JuanfraTr/cmos-image-sensor/README.md

[Informe del diseño y layout de un chip sensor de imagen CMOS](Informe_CMOS_Image_Sensor.pdf)
