JuanfraTr/cmos-image-sensor/Images/esquematico.PNG

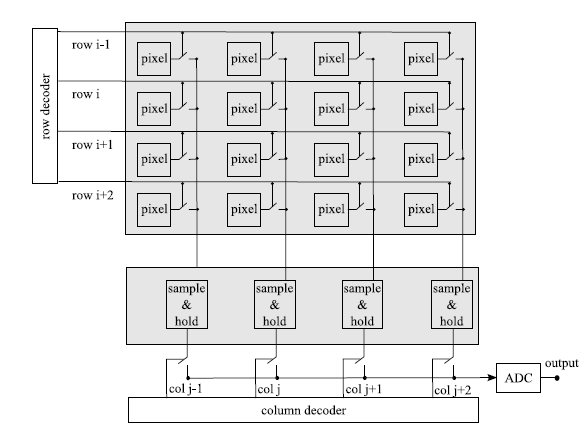
Images/esquematico.PNG
