JuanfraTr/cmos-image-sensor/Images/pinned.png

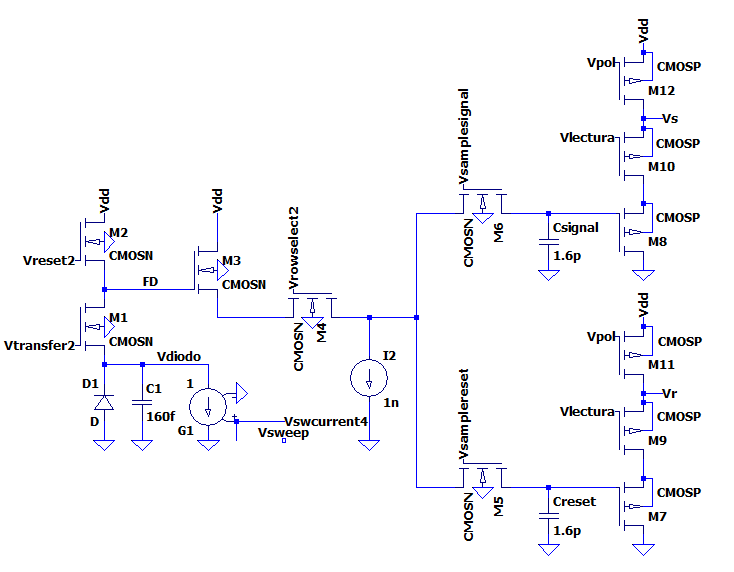
Images/pinned.png
