JuanfraTr/cmos-image-sensor/Images/tiempos.png

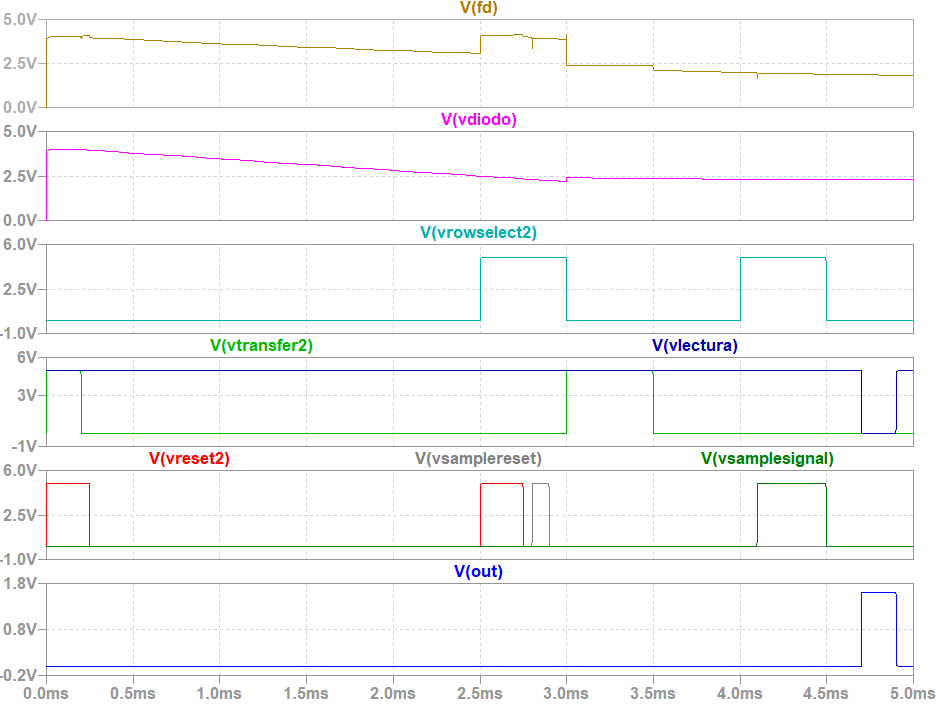
Images/tiempos.png
