JuanfraTr/cmos-image-sensor/Images/variandoCph.png

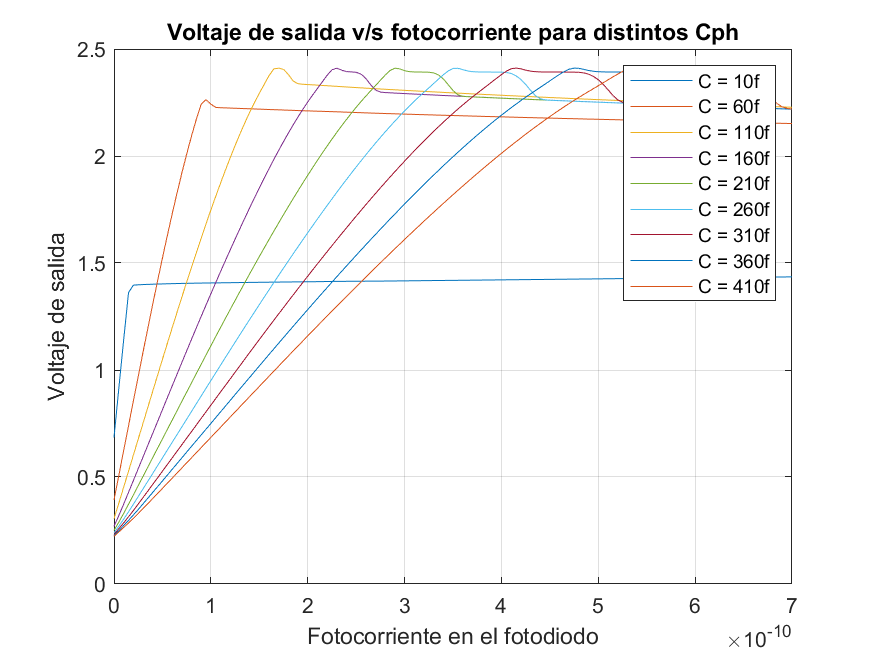
Images/variandoCph.png
