JuanfraTr/cmos-image-sensor/Images/variandoCsyCr.png

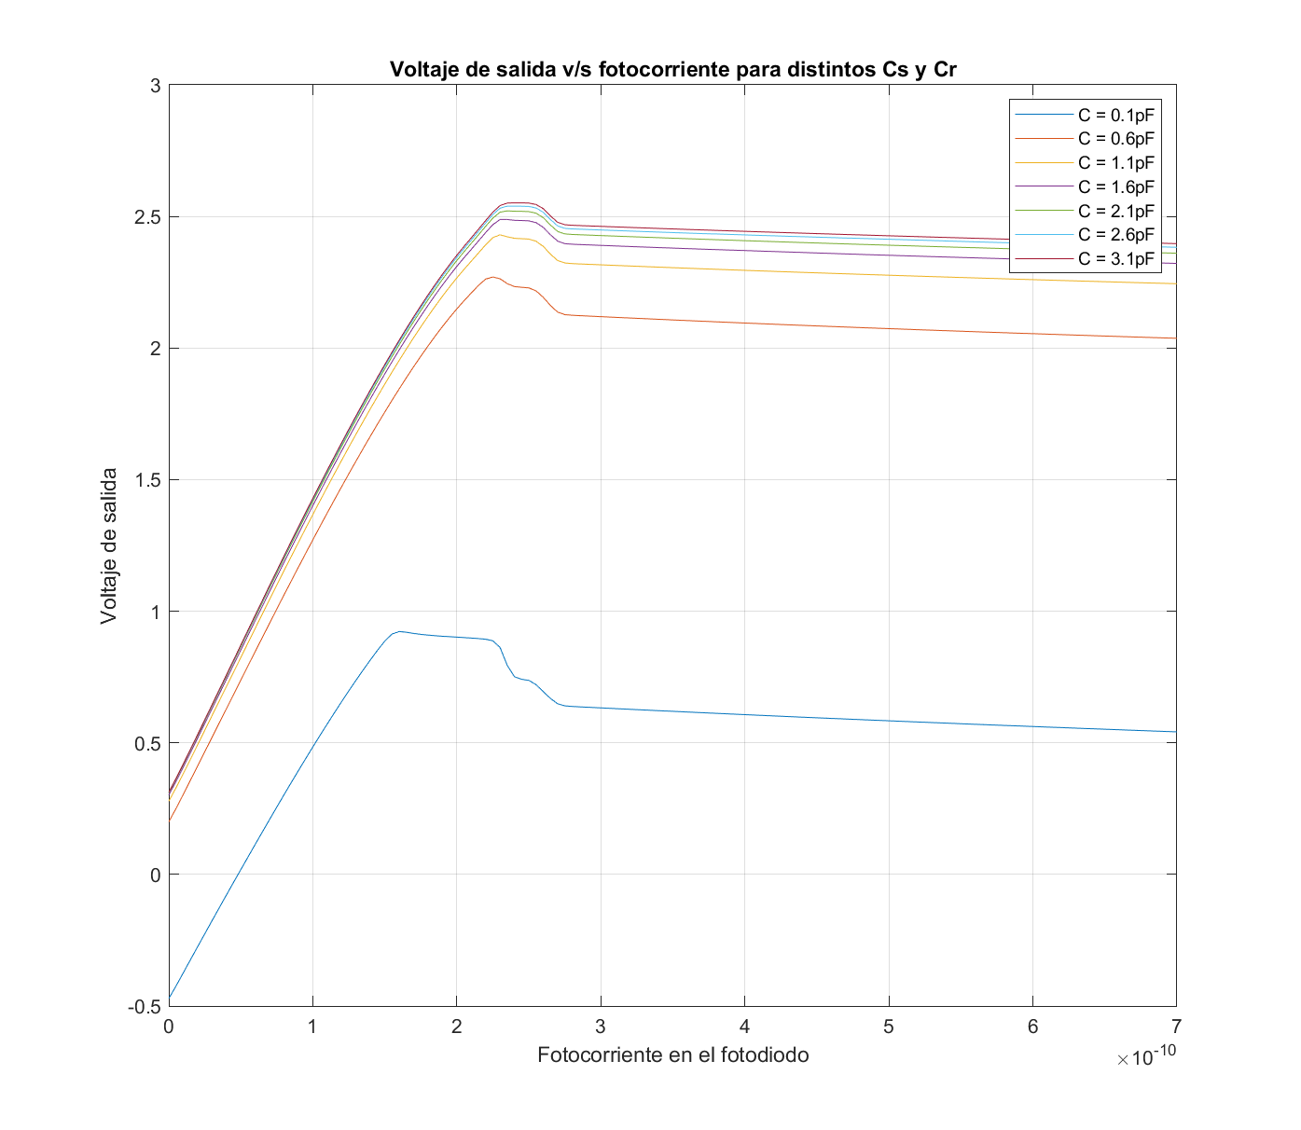
Images/variandoCsyCr.png
