JuanfraTr/cmos-image-sensor/Images/variandom.png

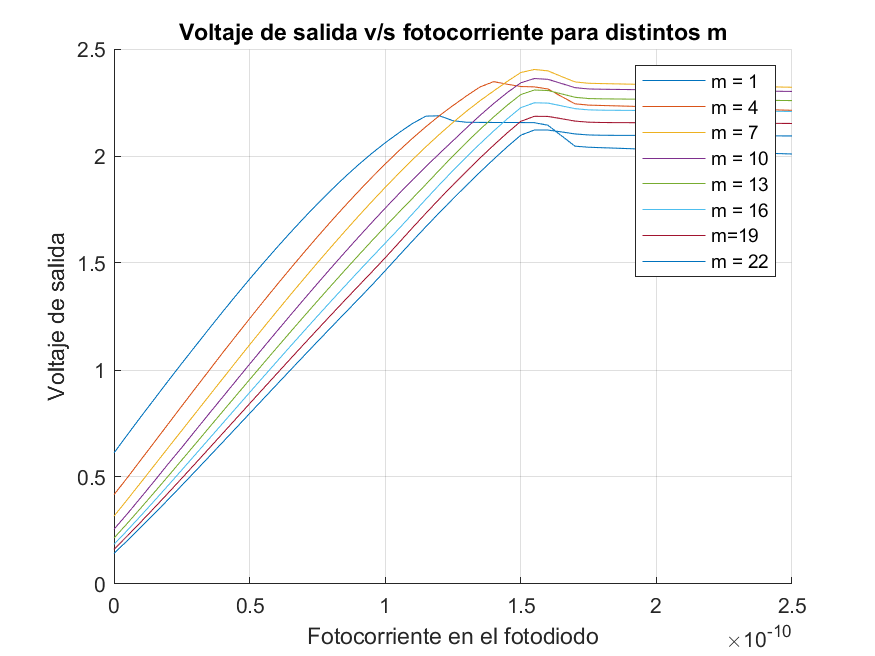
Images/variandom.png
