JuanfraTr/cmos-image-sensor/Images/variandoVpol.png

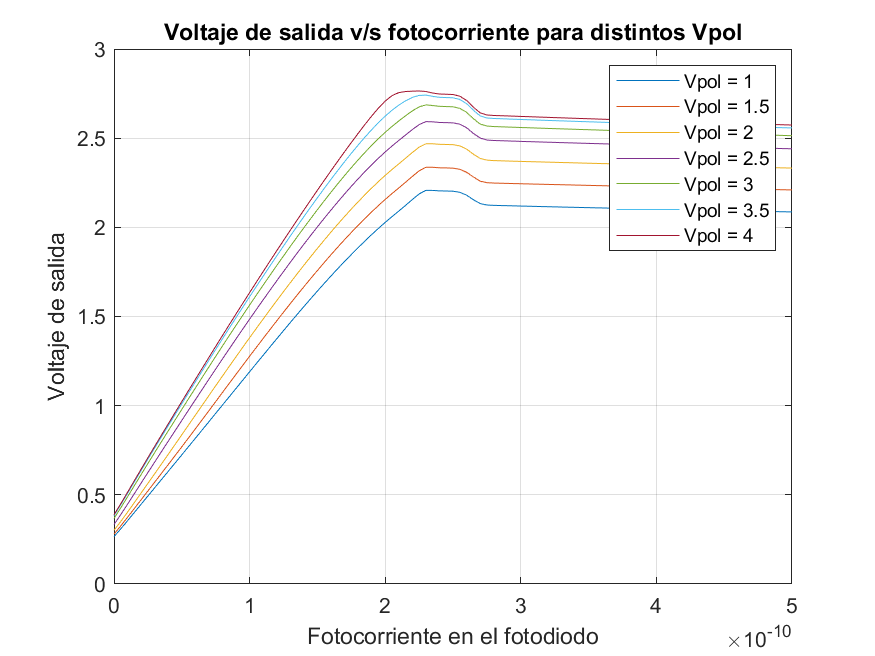
Images/variandoVpol.png
