JuanfraTr/cmos-image-sensor/Images/variandowp1.png

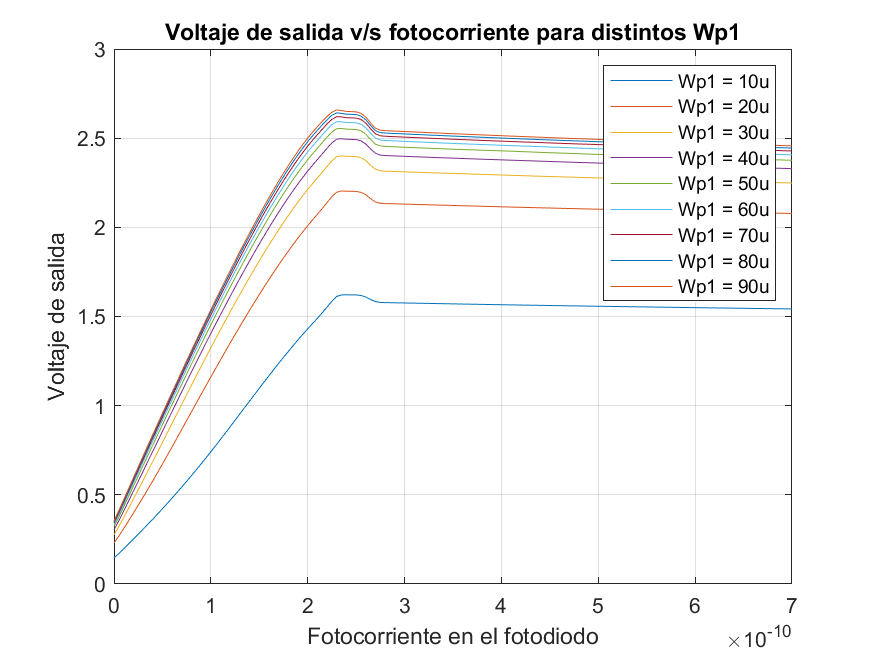
Images/variandowp1.png
