JuanfraTr/cmos-image-sensor/Images/variandoWp2.png

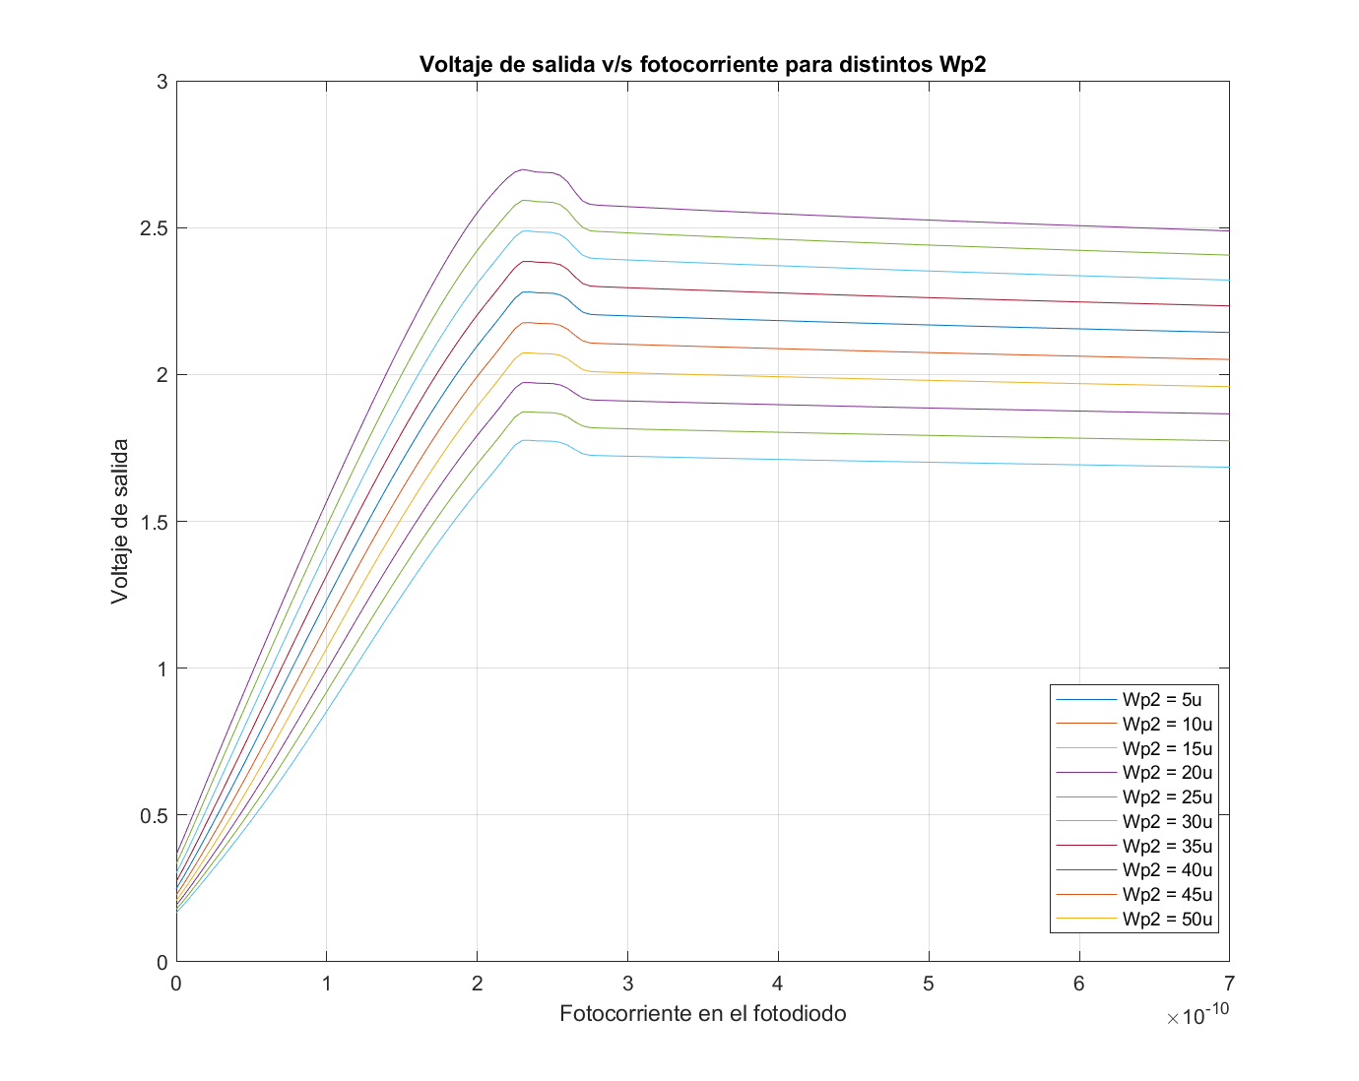
Images/variandoWp2.png
