JuanfraTr/cmos-image-sensor/Images/wchico.png

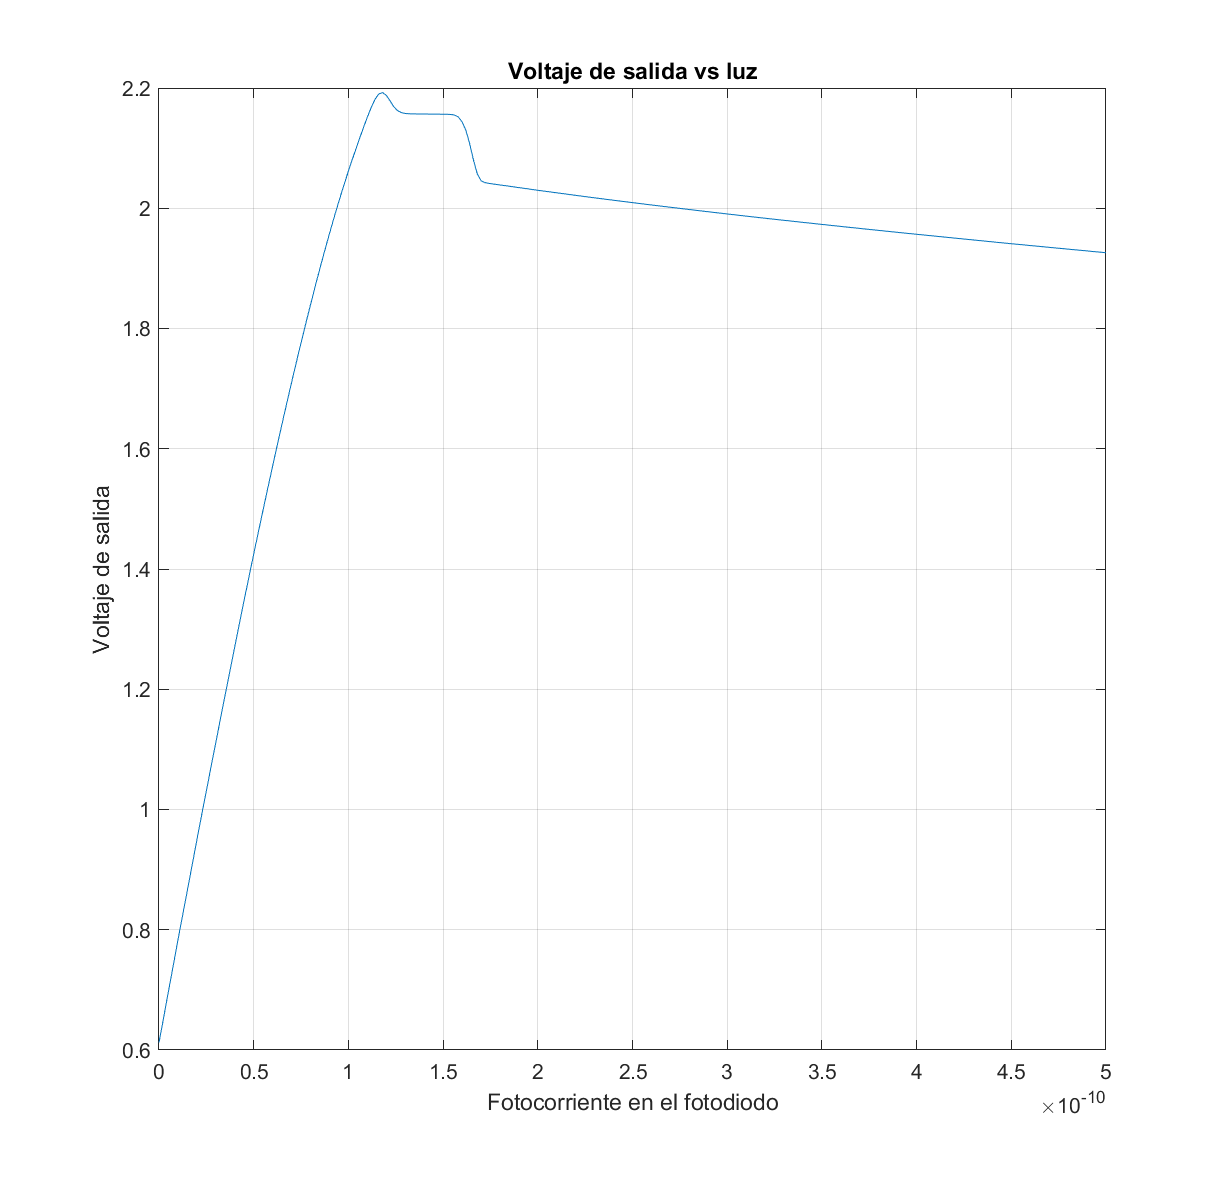
Images/wchico.png
