JuanfraTr/cmos-image-sensor/Images/wgrande.png

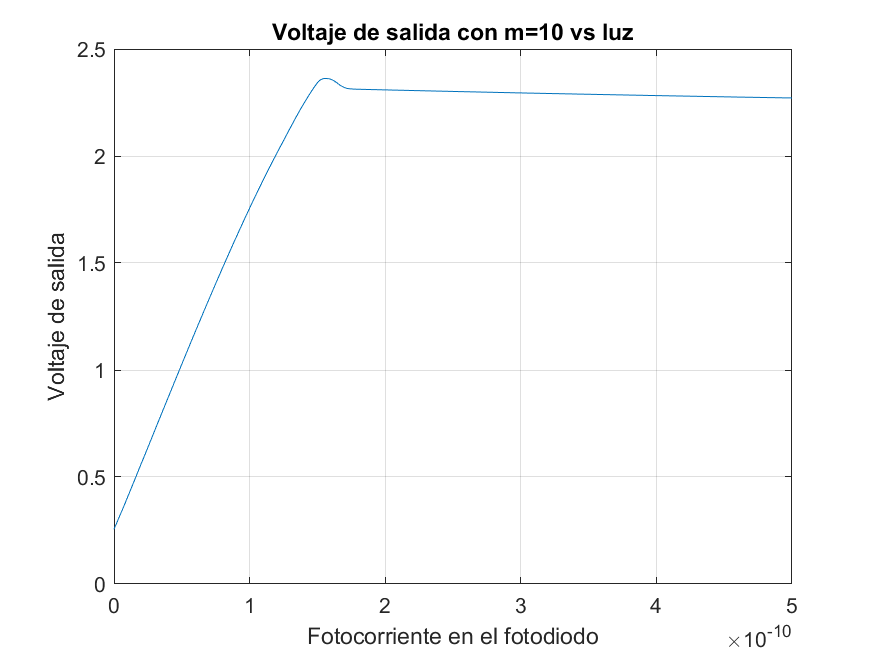
Images/wgrande.png
