JuanfraTr/cmos-image-sensor/Matlab Simulations/html/simulaciones_varias_01.png

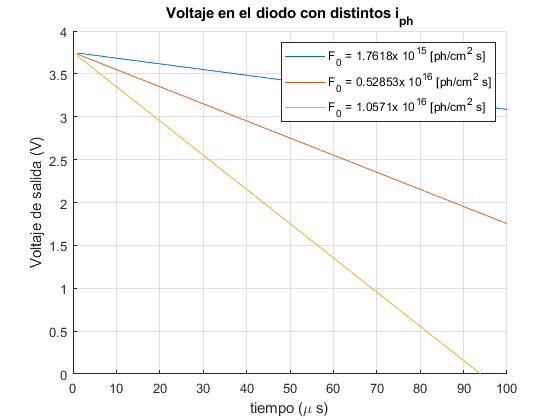
Matlab Simulations/html/simulaciones_varias_01.png
