JuanfraTr/cmos-image-sensor/SPICE Simulations/esquema_general.png

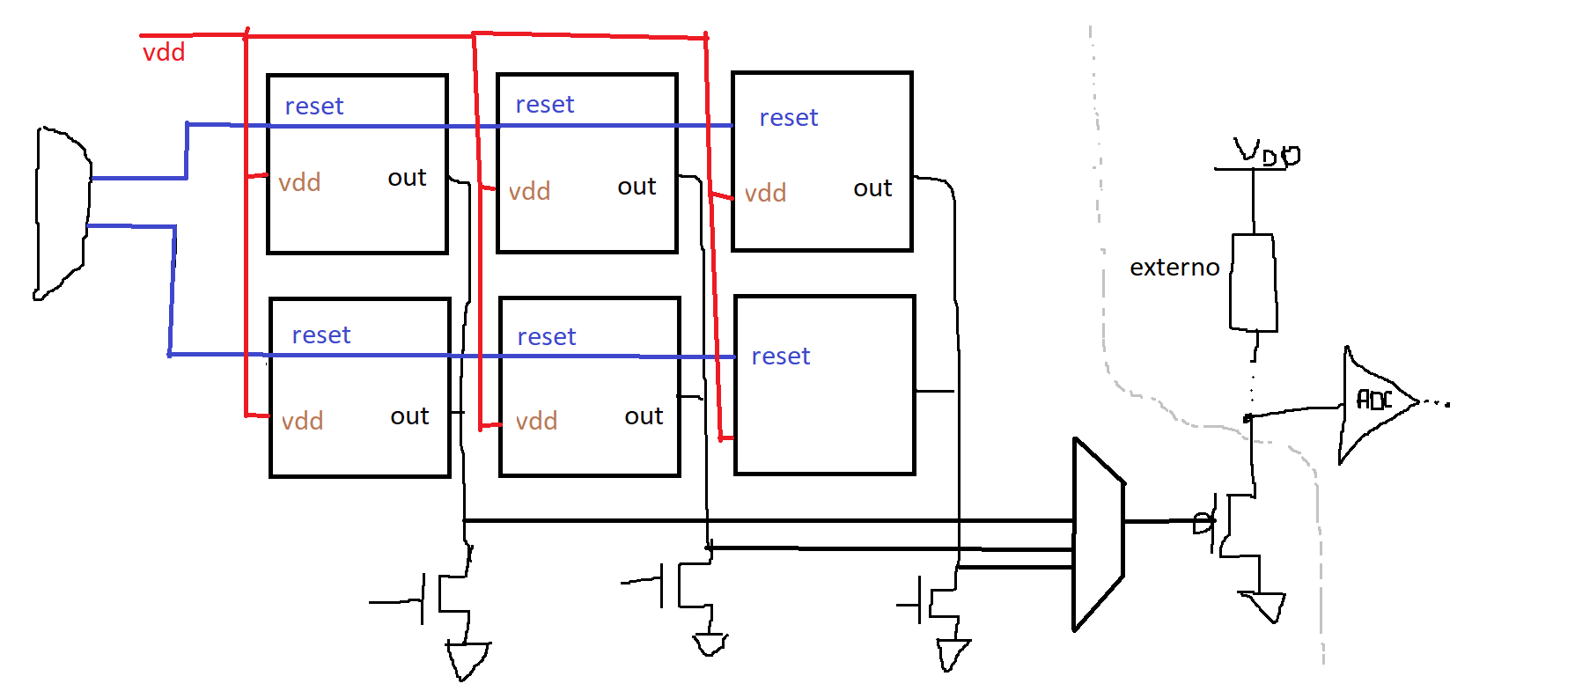
SPICE Simulations/esquema_general.png
