JuanfraTr/cmos-image-sensor/SPICE Simulations/Geometria_Aprox.png

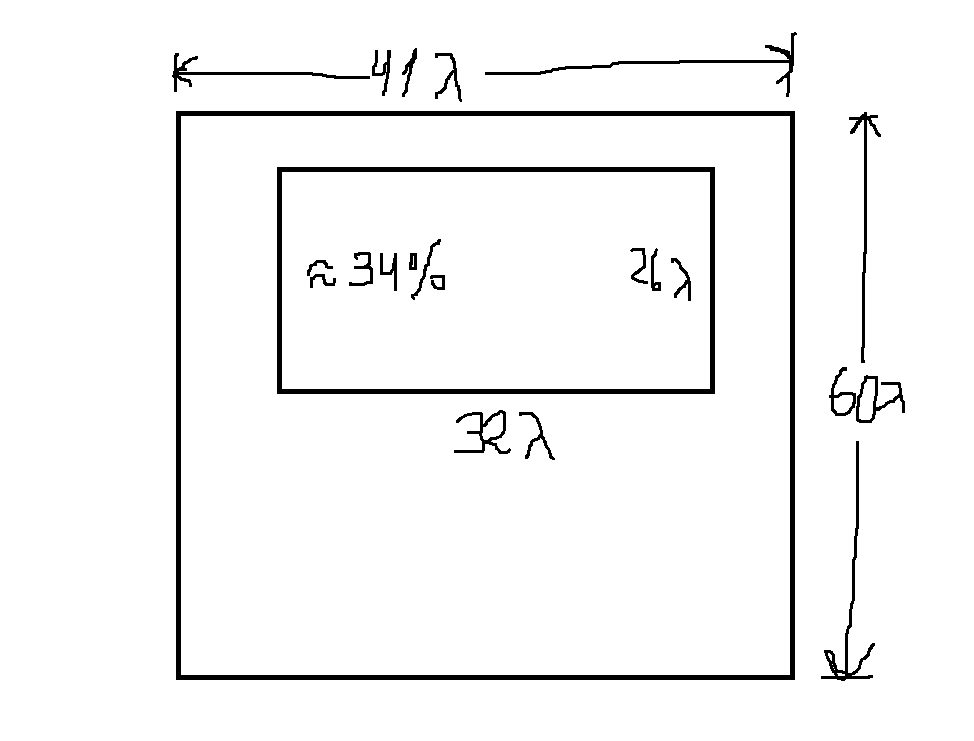
SPICE Simulations/Geometria_Aprox.png
