JuanfraTr/cmos-image-sensor/SPICE Simulations/3T-APS.asc

C1: cap; 2p
D1: diode; photodiode
G1: g; 1
M1: nmos4; l='Lmin' w='W' ad='W*Ld' as='W*Ld' pd='2*W+2*Ld' ps='2*W+2*Ld' m=1
M2: nmos4; l='Lmin' w='W' ad='W*Ld' as='W*Ld' pd='2*W+2*Ld' ps='2*W+2*Ld' m=1
M3: nmos4; l='Lmin' w='W' ad='W*Ld' as='W*Ld' pd='2*W+2*Ld' ps='2*W+2*Ld' m=1
M4: nmos4; l='Lbias' w='Wbias' ad='Wbias*Ld' as='Wbias*Ld' pd='2*Wbias+2*Ld' ps='2*Wbias+2*Ld' m=1
M5: pmos4; l='Lmin' w='Wbuf' ad='Ld*Wbuf' as='Ld*Wbuf' pd='2*Ld+2*Wbuf' ps='2*Ld+2*Wbuf' m=1
R1: res; 80k
V1: voltage; 5
V2: voltage; PULSE(0 5 0 1p 1p 'durpulsos' 'tperiodo' 4)
V3: voltage; PULSE(0 5 'taccess' 1p 1p 'durpulsos' 'tperiodo' 4)
V4: voltage; 1.5
V5: voltage; 0
V6: voltage; 0
V7: voltage; 0
V8: voltage; 0
V9: voltage; 0
V10: voltage; 0
V11: voltage; PULSE(0 'currentsweep' 200n 1p 1p 'tswcurrent' 'tperiodo' 2)
Named nets: 0, Vdd, Vreset, Vsweep, Vbias, Access, Vout, VPD
.param tperiodo = 20u
*.include IEE3433Lib_TT.sp
.param Lmin = 0.6u, W = 3u, Ld=1.5u
.param tswcurrent = 'tperiodo'
.param currentsweep=300p
.param durpulsos = 600n
*.ic V(Vdiodo) = 0
.model photodiode D (IS = 50f CJO=11.07f  VJ= 0.636 M=0.33)
.tran 60u
.param Lbias = 20.1u, Wbias = 5.1u
.param taccess = 18u
.param Wbuf=40u
*.step param Wbias 1u 10u 2u
.include C5_models.txt
