JuanfraTr/cmos-image-sensor/SPICE Simulations/buffer.asc

M1: pmos4; l='Lmin' w='Wbuf' ad='Ld*Wbuf' as='Ld*Wbuf' pd='2*Ld+2*Wbuf' ps='2*Ld+2*Wbuf' m=1
M2: pmos4; l='Lmin' w='Wbuf' ad='Ld*Wbuf' as='Ld*Wbuf' pd='2*Ld+2*Wbuf' ps='2*Ld+2*Wbuf' m=1
M3: pmos4; l='Lmin' w='Wbuf' ad='Ld*Wbuf' as='Ld*Wbuf' pd='2*Ld+2*Wbuf' ps='2*Ld+2*Wbuf' m=1
M4: pmos4; l='Lmin' w='Wbuf' ad='Ld*Wbuf' as='Ld*Wbuf' pd='2*Ld+2*Wbuf' ps='2*Ld+2*Wbuf' m=1
M5: pmos4; l='Lmin' w='Wbuf' ad='Ld*Wbuf' as='Ld*Wbuf' pd='2*Ld+2*Wbuf' ps='2*Ld+2*Wbuf' m=1
M6: pmos4; l='Lmin' w='Wbuf' ad='Ld*Wbuf' as='Ld*Wbuf' pd='2*Ld+2*Wbuf' ps='2*Ld+2*Wbuf' m=1
M7: pmos4; l='Lmin' w='Wbuf' ad='Ld*Wbuf' as='Ld*Wbuf' pd='2*Ld+2*Wbuf' ps='2*Ld+2*Wbuf' m=1
M8: pmos4; l='Lmin' w='Wbuf' ad='Ld*Wbuf' as='Ld*Wbuf' pd='2*Ld+2*Wbuf' ps='2*Ld+2*Wbuf' m=1
V1: voltage; 5
V2: voltage; 1.5
V3: voltage; 1.5
V4: voltage; 0
Named nets: Vdd, 0
.dc V3 0 5 1m
.param Wbuf=5.7u
.param Lmin = 0.6u, W = 2.4u, Ld=1.2u
.include C5_models.txt
