JuanfraTr/cmos-image-sensor/SPICE Simulations/column_vias.asc

M5: nmos4; l='Lbias' w='Wbias' ad='Wbias*Ld' as='Wbias*Ld' pd='2*Wbias+2*Ld' ps='2*Wbias+2*Ld' m=1
M6: nmos4; l='Lbias' w='Wbias' ad='Wbias*Ld' as='Wbias*Ld' pd='2*Wbias+2*Ld' ps='2*Wbias+2*Ld' m=1
M7: nmos4; l='Lbias' w='Wbias' ad='Wbias*Ld' as='Wbias*Ld' pd='2*Wbias+2*Ld' ps='2*Wbias+2*Ld' m=1
M8: nmos4; l='Lbias' w='Wbias' ad='Wbias*Ld' as='Wbias*Ld' pd='2*Wbias+2*Ld' ps='2*Wbias+2*Ld' m=1
M10: nmos4; l='Lbias' w='Wbias' ad='Wbias*Ld' as='Wbias*Ld' pd='2*Wbias+2*Ld' ps='2*Wbias+2*Ld' m=1
V1: voltage; 1.5
V2: voltage; 1.5
Named nets: 0, vd
.include C5_models.txt
.param Lbias = 3.9u, Wbias = 5.4u
.dc V2 0 5 1m
.param Ld = 1.2u
