JuanfraTr/cmos-image-sensor/SPICE Simulations/Decoder.asc

C2: cap; 5p
V1: voltage; 5
V2: voltage; 5
V3: voltage; 5
V4: voltage; 5
V5: voltage; 5
V6: voltage; 5
V7: voltage; 5
X1: NAND3; Wnmos1 = 18 Wpmos1 = 12u
X9: INV
X10: INV
X11: INV
X12: INV; Wnmos1 = 6u Wpmos1 = 12u
X20: NAND4; Wnmos1 = 24u Wpmos1 = 12u
X21: INV
X22: INV
X23: INV
X24: INV; Wnmos1 = 24u Wpmos1 = 48u
Named nets: 0, in1, in2, in3, out1, Vdd, NegIn1, NegIn2, NegIn3, in4, in5, in6, out_real_1, NegIn4, NegIn5, NegIn6
.include C5_models.txt
.tran 1u
.param Lmin = 0.6u
.ic V(out1) = 0
555
.ic V(out_real_1) = 0
