JuanfraTr/cmos-image-sensor/SPICE Simulations/INV.asc

M1: nmos4; l='Lmin' w='Wnmos1' ad='Lmin*Wnmos1' as='Lmin*Wnmos1' pd='2*(Lmin+Wnmos1)' ps='2*(Lmin+Wnmos1)' m=1
M2: pmos4; l='Lmin' w='Wpmos1' ad='Lmin*Wpmos1' as='Lmin*Wpmos1' pd='2*(Lmin+Wpmos1)' ps='2*(Lmin+Wpmos1)' m=1
V1: voltage; 5
Named nets: 0, Vdd, a, o
.include C5_models.txt
.param Lmin = 0.6u
