JuanfraTr/cmos-image-sensor/SPICE Simulations/shift.asc

M1: pmos4; l='Lmin' w='Wpmos1' ad='Lmin*Wpmos1' as='Lmin*Wpmos1' pd='2*(Lmin+Wpmos1)' ps='2*(Lmin+Wpmos1)' m=1
M2: pmos4; l='Lmin' w='Wpmos1' ad='Lmin*Wpmos1' as='Lmin*Wpmos1' pd='2*(Lmin+Wpmos1)' ps='2*(Lmin+Wpmos1)' m=1
M3: nmos4; l='Lmin' w='Wnmos1' ad='Lmin*Wnmos1' as='Lmin*Wnmos1' pd='2*(Lmin+Wnmos1)' ps='2*(Lmin+Wnmos1)' m=1
M4: nmos4; l='Lmin' w='Wnmos1' ad='Lmin*Wnmos1' as='Lmin*Wnmos1' pd='2*(Lmin+Wnmos1)' ps='2*(Lmin+Wnmos1)' m=1
M5: pmos4; l='Lmin' w='Wpmos1' ad='Lmin*Wpmos1' as='Lmin*Wpmos1' pd='2*(Lmin+Wpmos1)' ps='2*(Lmin+Wpmos1)' m=1
M6: nmos4; l='Lmin' w='Wnmos1' ad='Lmin*Wnmos1' as='Lmin*Wnmos1' pd='2*(Lmin+Wnmos1)' ps='2*(Lmin+Wnmos1)' m=1
M7: pmos4; l='Lmin' w='Wpmos2' ad='Lmin*Wpmos2' as='Lmin*Wpmos2' pd='2*(Lmin+Wpmos2)' ps='2*(Lmin+Wpmos2)' m=1
M8: nmos4; l='Lmin' w='Wnmos2' ad='Lmin*Wnmos2' as='Lmin*Wnmos2' pd='2*(Lmin+Wnmos2)' ps='2*(Lmin+Wnmos2)' m=1
M9: pmos4; l='Lmin' w='Wpmos1' ad='Lmin*Wpmos1' as='Lmin*Wpmos1' pd='2*(Lmin+Wpmos1)' ps='2*(Lmin+Wpmos1)' m=1
V1: voltage; 5
Named nets: Vdd, 0, D, clk, clkb, reset, Q, Qneg
.include C5_models.txt
.param Wnmos1 = 6u Wnmos2 = 12u
.param Wpmos1 = 12u Wpmos2 = 24u
.param Lmin = 0.6u
