JuanfraTr/cmos-image-sensor/SPICE Simulations/shift_register.asc

C1: cap; 5p
M1: pmos4; l='Lmin' w='Wpmos1' ad='Lmin*Wpmos1' as='Lmin*Wpmos1' pd='2*(Lmin+Wpmos1)' ps='2*(Lmin+Wpmos1)' m=1
M2: nmos4; l='Lmin' w='Wnmos1' ad='Lmin*Wnmos1' as='Lmin*Wnmos1' pd='2*(Lmin+Wnmos1)' ps='2*(Lmin+Wnmos1)' m=1
M3: pmos4; l='Lmin' w='Wpmos1' ad='Lmin*Wpmos1' as='Lmin*Wpmos1' pd='2*(Lmin+Wpmos1)' ps='2*(Lmin+Wpmos1)' m=1
M4: nmos4; l='Lmin' w='Wnmos1' ad='Lmin*Wnmos1' as='Lmin*Wnmos1' pd='2*(Lmin+Wnmos1)' ps='2*(Lmin+Wnmos1)' m=1
M5: pmos4; l='Lmin' w='Wpmos1' ad='Lmin*Wpmos1' as='Lmin*Wpmos1' pd='2*(Lmin+Wpmos1)' ps='2*(Lmin+Wpmos1)' m=1
M6: nmos4; l='Lmin' w='Wnmos1' ad='Lmin*Wnmos1' as='Lmin*Wnmos1' pd='2*(Lmin+Wnmos1)' ps='2*(Lmin+Wnmos1)' m=1
M7: pmos4; l='Lmin' w='Wpmos1' ad='Lmin*Wpmos1' as='Lmin*Wpmos1' pd='2*(Lmin+Wpmos1)' ps='2*(Lmin+Wpmos1)' m=1
M8: nmos4; l='Lmin' w='Wnmos1' ad='Lmin*Wnmos1' as='Lmin*Wnmos1' pd='2*(Lmin+Wnmos1)' ps='2*(Lmin+Wnmos1)' m=1
V1: voltage; PULSE(5 0 0 1p 1p 0.1u 0.2u 5)
V2: voltage; PULSE(0 5 0.2u 1p 1p 0.2u)
V3: voltage; PULSE(5 0 0 1p 1p 0.1u)
V4: voltage; 0
V5: voltage; 1.5
V6: voltage; 2
V7: voltage; 4
V8: voltage; 5
X1: shift
X2: shift
X3: shift
X4: INV
X5: shift
X6: INV; Wnmos1 = 6u Wpmos1 = 12u
X7: INV; Wnmos1 = 6u Wpmos1 = 12u
X8: INV; Wnmos1 = 6u Wpmos1 = 12u
X9: INV; Wnmos1 = 6u Wpmos1 = 12u
Named nets: 0, Vin, clk, clkb, reset, a1, a2, a3, a4, na1, va1, na2, va2, vdd, na3, va3, na4, va4
.tran 2u
.include C5_models.txt
.param Lmin = 0.6u
.param Wnmos1 = 6u Wpmos1 = 12u
