JuanfraTr/cmos-image-sensor/SPICE Simulations/Variations/Pinned with CDS/4TAPS.asc

C1: cap; 160f
Creset: cap; 1.6p
Csignal: cap; 1.6p
D1: diode
E1: e; 1
G1: g; 1
M1: nmos4; CMOSN; l='Lmin' w='W' ad='W*Ld' as='W*Ld' pd='2*W+2*Ld' ps='2*W+2*Ld' m=1
M2: nmos4; CMOSN; l='Lmin' w='W' ad='W*Ld' as='W*Ld' pd='2*W+2*Ld' ps='2*W+2*Ld' m=1
M3: nmos4; CMOSN; l='Lmin' w='W' ad='W*Ld' as='W*Ld' pd='2*W+2*Ld' ps='2*W+2*Ld' m=7
M4: nmos4; CMOSN; l='Lmin' w='W' ad='W*Ld' as='W*Ld' pd='2*W+2*Ld' ps='2*W+2*Ld' m=1
M5: nmos4; CMOSN; l='Lmin' w='W' ad='W*Ld' as='W*Ld' pd='2*W+2*Ld' ps='2*W+2*Ld' m=1
M6: nmos4; CMOSN; l='Lmin' w='W' ad='W*Ld' as='W*Ld' pd='2*W+2*Ld' ps='2*W+2*Ld' m=1
M7: pmos4; CMOSP; l='Lmin' w='Wp1' ad='Wp1*Ld' as='Wp1*Ld' pd='2*Wp1+2*Ld' ps='2*Wp1+2*Ld' m=1
M8: pmos4; CMOSP; l='Lmin' w='Wp1' ad='Wp1*Ld' as='Wp1*Ld' pd='2*Wp1+2*Ld' ps='2*Wp1+2*Ld' m=1
M9: pmos4; CMOSP; l='Lmin' w='Wp1' ad='Wp1*Ld' as='Wp1*Ld' pd='2*Wp1+2*Ld' ps='2*Wp1+2*Ld' m=1
M10: pmos4; CMOSP; l='Lmin' w='Wp1' ad='Wp1*Ld' as='Wp1*Ld' pd='2*Wp1+2*Ld' ps='2*Wp1+2*Ld' m=1
M11: pmos4; CMOSP; l='Lmin' w='Wp2' ad='Wp2*Ld' as='Wp2*Ld' pd='2*Wp2+2*Ld' ps='2*Wp2+2*Ld' m=1
M12: pmos4; CMOSP; l='Lmin' w='Wp2' ad='Wp2*Ld' as='Wp2*Ld' pd='2*Wp2+2*Ld' ps='2*Wp2+2*Ld' m=1
M13: nmos4; CMOSN; l='Lmin' w='W' ad='W*Ld' as='W*Ld' pd='2*W+2*Ld' ps='2*W+2*Ld' m=1
M14: nmos4; CMOSN; l='Lmin' w='W' ad='W*Ld' as='W*Ld' pd='2*W+2*Ld' ps='2*W+2*Ld' m=1
R1: res; 30k
V1: voltage; 5
V2: voltage; PULSE(0 5 0 1p 1p 'treset1' 'tperiodo' 4)
V3: voltage; PULSE(0 5 0 1p 1p 'ttransfer1' 'tperiodo' 4)
V4: voltage; PULSE(0 5 'rowselect1' 1p 1p 0.5m 'tperiodo' 4)
V5: voltage; PULSE(0 5 'treset2' 1p 1p 0.25m 'tperiodo' 4)
V6: voltage; PULSE(0 5 'ttransfer2' 1p 1p 0.5m 'tperiodo' 4)
V7: voltage; PULSE(0 'current1' 0 1p 1p 'tswcurrent' 'tperiodo' 1)
V8: voltage; PULSE(0 'current2' 5m 1p 1p 'tswcurrent' 'tperiodo' 1)
V9: voltage; PULSE(0 'current3' 10m 1p 1p 'tswcurrent' 'tperiodo' 1)
V10: voltage; PULSE(0 'current4' 15m 1p 1p 'tswcurrent' 'tperiodo' 1)
V11: voltage; PULSE(0 'currentsweep' 0 1p 1p 'tswcurrent' 'tperiodo' 1)
V12: voltage; PULSE(0 5 'trsampleo' 1p 1p 'tonreset' 5m 4)
V13: voltage; PULSE(0 5 'tssampleo' 1p 1p 'tonsignal' 5ms 4)
V14: voltage; PULSE(0 5 'rowselect2' 1p 1p 0.5m 'tperiodo' 4)
V15: voltage; 3
V16: voltage; PULSE(5 0 'tlectura' 1p 1p 0.2m 5ms 4)
V17: voltage; 1.25
Named nets: 0, Vdd, Vreset, Vtransfer, Vtransfer2, Vrowselect, Vreset2, Vrowselect2, Vdiodo, Vswcurrent1, Vswcurrent4, Vswcurrent2, Vswcurrent3, FD, Vsweep, Vsamplesignal, Vsamplereset, Vpol, Vlectura, Vr, Vs, out, Vespejo
.tran 5m *Solo un ciclo
.param tperiodo = 5m
.param treset1 = 0.25m
.param ttransfer1 = 0.20m
.include IEE3433Lib_TT.sp
.param rowselect2 = 4m
.param Lmin = 0.6u, W = 3u, Ld=1.2u
.param treset2 = 2.5m
.param ttransfer2 = 3m
.param tswcurrent = 3m
.param current1 = 100p, current2= 50p, current3=10p, current4=0p
.MEAS TRAN vout1 FIND V(out) AT 4.8m
.MEAS TRAN vout2 FIND V(out) AT 9.8m
.MEAS TRAN vout3 FIND V(out) AT 14.8m
.MEAS TRAN vout4 FIND V(out) AT 19.8m
.param currentsweep=100p
.tran 20m * Cuatro ciclos
Photocurrent
.param tssampleo = 4.1m
.param tonsignal = 0.4m
.param trsampleo = 2.8m
.param tonreset = 0.1m
.param rowselect1 = 2.5m
.param Wp1 = 60u, Wp2 = 10u
.param tlectura = 4.7m
.op
