JuanfraTr/cmos-image-sensor/SPICE Simulations/Variations/Pinned without CDS/4TAPS.asc

C1: cap; 100f
D1: diode
G1: g; 1
I2: current; 1n
M1: nmos4; CMOSN; l='Lmin' w='W' ad='W*Ld' as='W*Ld' pd='2*W+2*Ld' ps='2*W+2*Ld' m=1
M2: nmos4; CMOSN; l='Lmin' w='W' ad='W*Ld' as='W*Ld' pd='2*W+2*Ld' ps='2*W+2*Ld' m=1
M3: nmos4; CMOSN; l='Lmin' w='W' ad='W*Ld' as='W*Ld' pd='2*W+2*Ld' ps='2*W+2*Ld' m=1
M4: nmos4; CMOSN; l='Lmin' w='W' ad='W*Ld' as='W*Ld' pd='2*W+2*Ld' ps='2*W+2*Ld' m=1
V1: voltage; 5
V2: voltage; PULSE(0 5 0 1p 1p 'treset1' 'tperiodo' 4)
V3: voltage; PULSE(0 5 0 1p 1p 'ttransfer1' 'tperiodo' 4)
V4: voltage; PULSE(0 5 'rowselect' 1p 1p 0.5m 'tperiodo' 4)
V5: voltage; PULSE(0 5 'treset2' 1p 1p 0.25m 'tperiodo' 4)
V6: voltage; PULSE(0 5 'ttransfer2' 1p 1p 0.5m 'tperiodo' 4)
V7: voltage; PULSE(0 'current1' 0 1p 1p 'tswcurrent' 'tperiodo' 1)
V8: voltage; PULSE(0 'current2' 5m 1p 1p 'tswcurrent' 'tperiodo' 1)
V9: voltage; PULSE(0 'current3' 10m 1p 1p 'tswcurrent' 'tperiodo' 1)
V10: voltage; PULSE(0 'current4' 15m 1p 1p 'tswcurrent' 'tperiodo' 1)
V11: voltage; PULSE(0 'currentsweep' 0 1p 1p 'tswcurrent' 'tperiodo' 1)
Named nets: 0, Vdd, Vreset, Vtransfer, Vtransfer2, Vrowselect, Vreset2, Vdiodo, Vswcurrent1, Vswcurrent4, Vswcurrent2, Vswcurrent3, FD, out, Vsweep
.tran 5m *Solo un ciclo
.param tperiodo = 5m
.param treset1 = 0.25m
.param ttransfer1 = 0.20m
.include IEE3433Lib_TT.sp
.param rowselect = 4m
.param Lmin = 0.6u, W = 3u, Ld=1.2u
.param treset2 = 2.5m
.param ttransfer2 = 3m
.param tswcurrent = 3m
.param current1 = 100p, current2= 50p, current3=10p, current4=0p
.MEAS TRAN vout1 FIND V(out) AT 4.25m
.MEAS TRAN vout2 FIND V(out) AT 9.25m
.MEAS TRAN vout3 FIND V(out) AT 14.25m
.MEAS TRAN vout4 FIND V(out) AT 19.25m
.param currentsweep=100p
*.tran 20m * Cuatro ciclos
